dustpot/electronic-test-bench/software/readme.md

Run checkA_main.py to start the system.

Modules used by checkA_main.py:
- adc.py
- digipot_dual.py
- inputs.py
- lcd.py
- freq_measure.py
