dustpot/electronic-test-bench/hardware/schematics/Ohmmeter.pdf

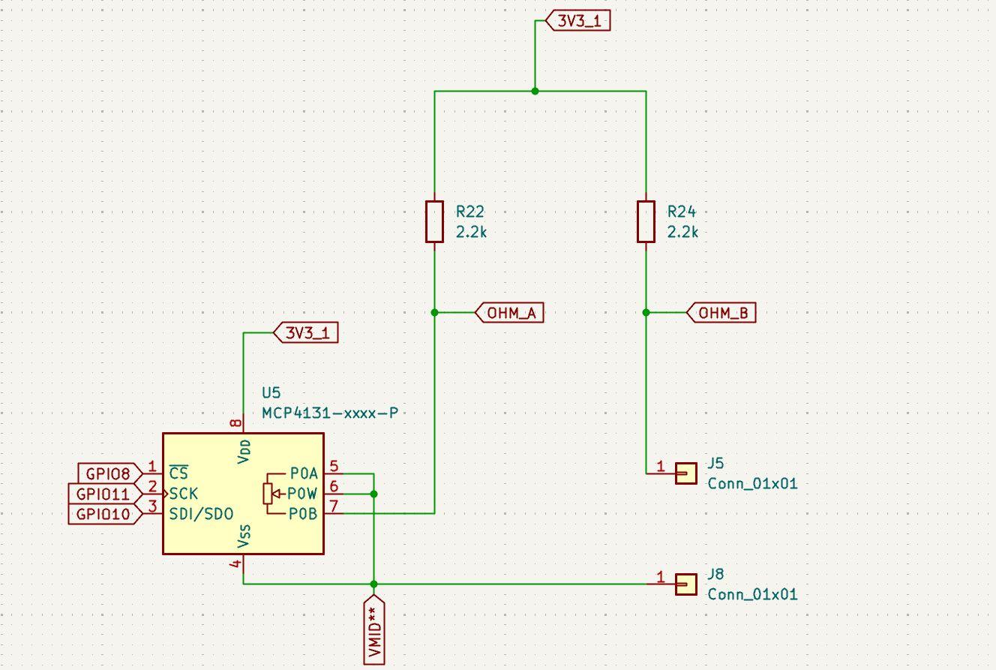
[picture p26: page 1]
