dustpot/electronic-test-bench/hardware/schematics/R2R_Ladder_ADC.pdf

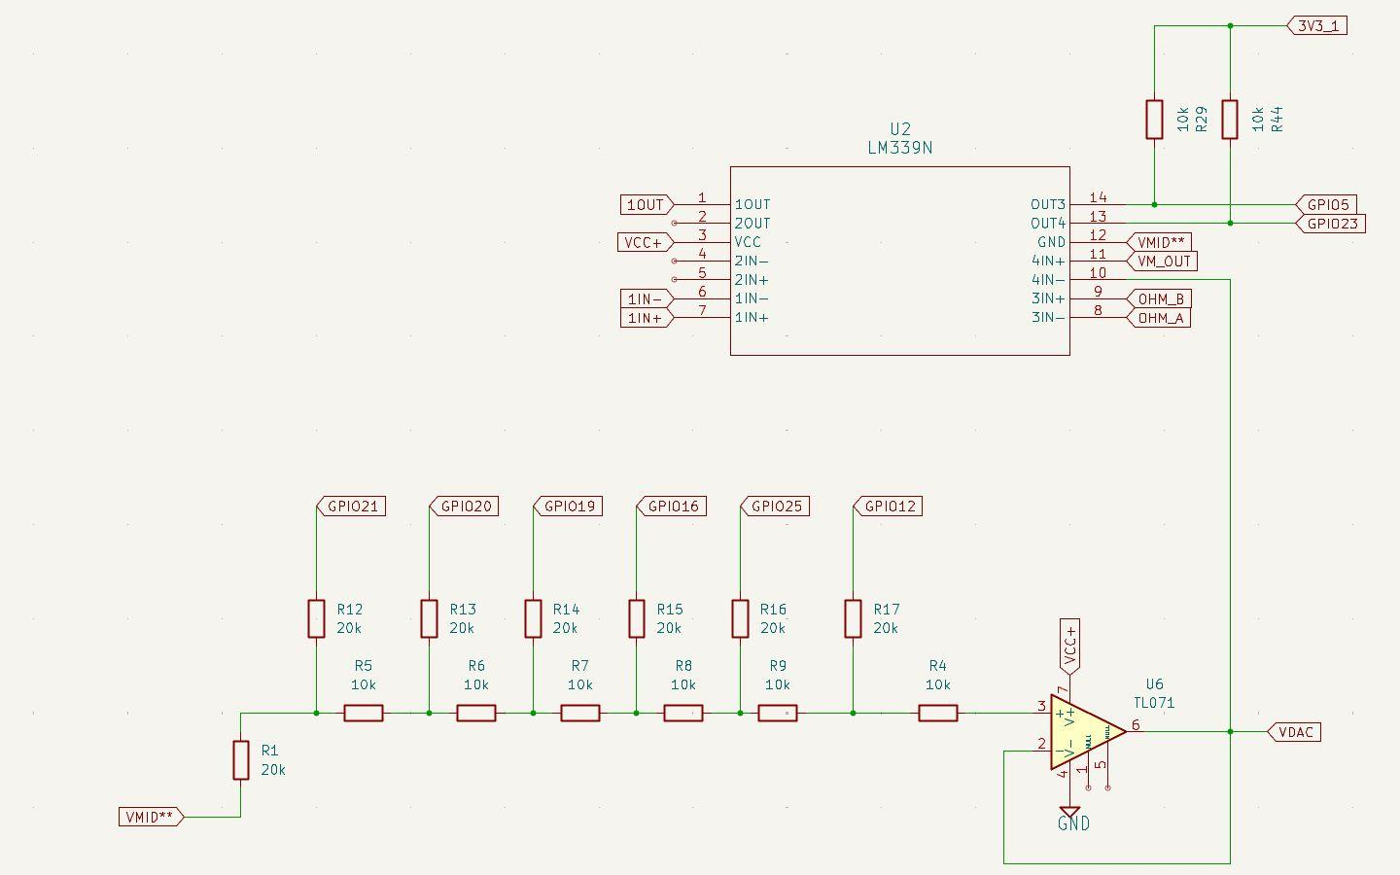
[picture p27: page 1]
