dustpot/electronic-test-bench/hardware/schematics/Virtual_Ground_Power_Supply.pdf

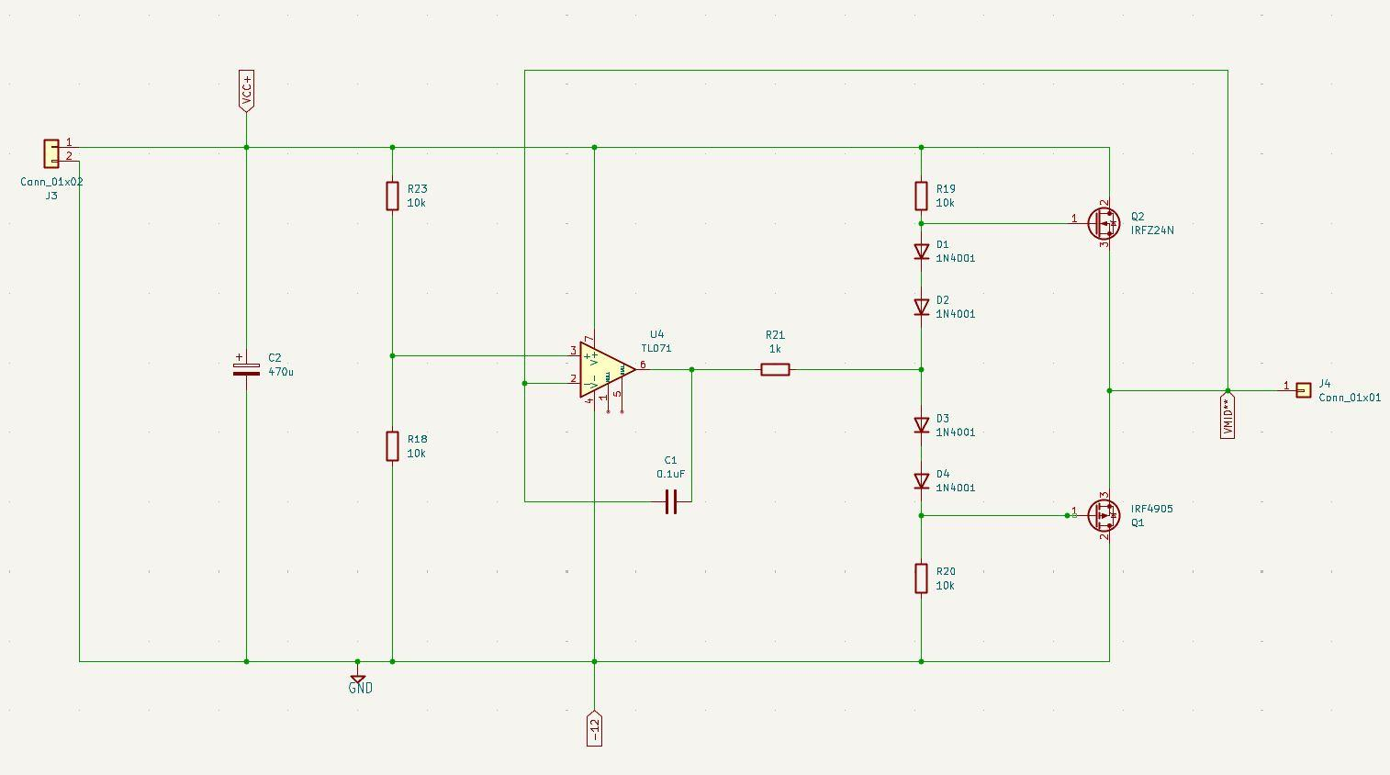
[picture p28: page 1]
