dustpot/electronic-test-bench/hardware/schematics/Voltmeter.pdf

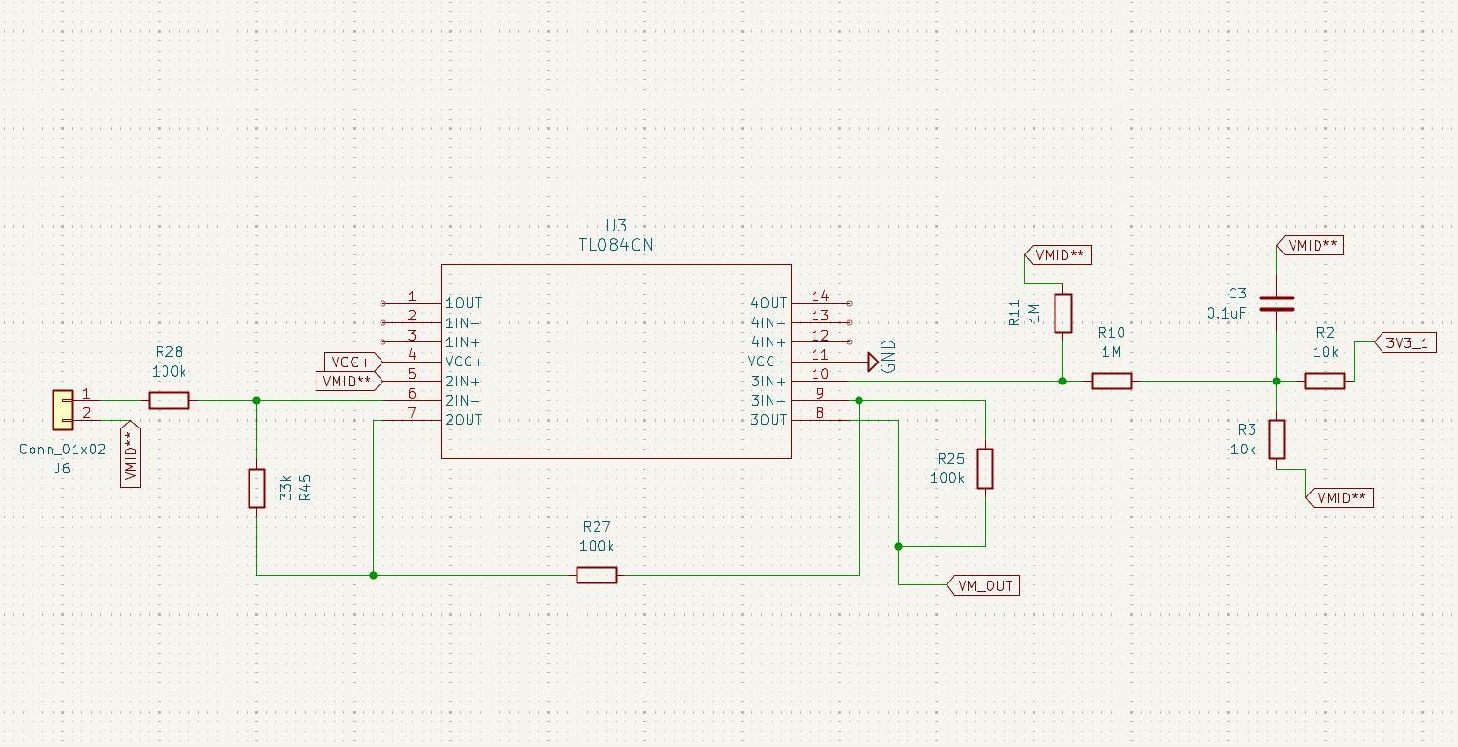
[picture p29: page 1]
