dustpot/electronic-test-bench/hardware/schematics/DC_Reference.pdf

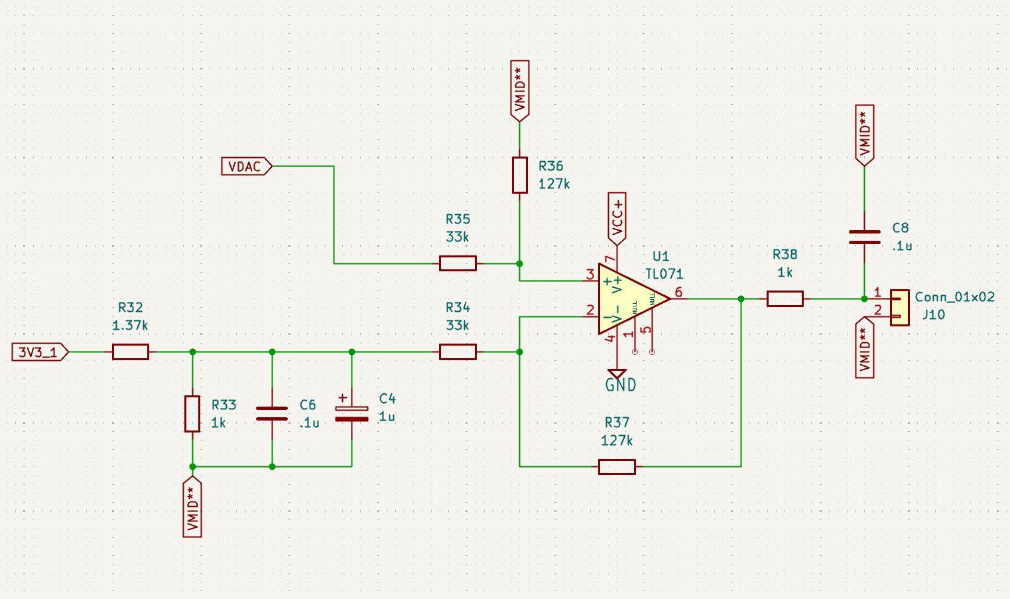
[picture p30: page 1]
