dustpot/electronic-test-bench/hardware/schematics/Function_Generator.pdf

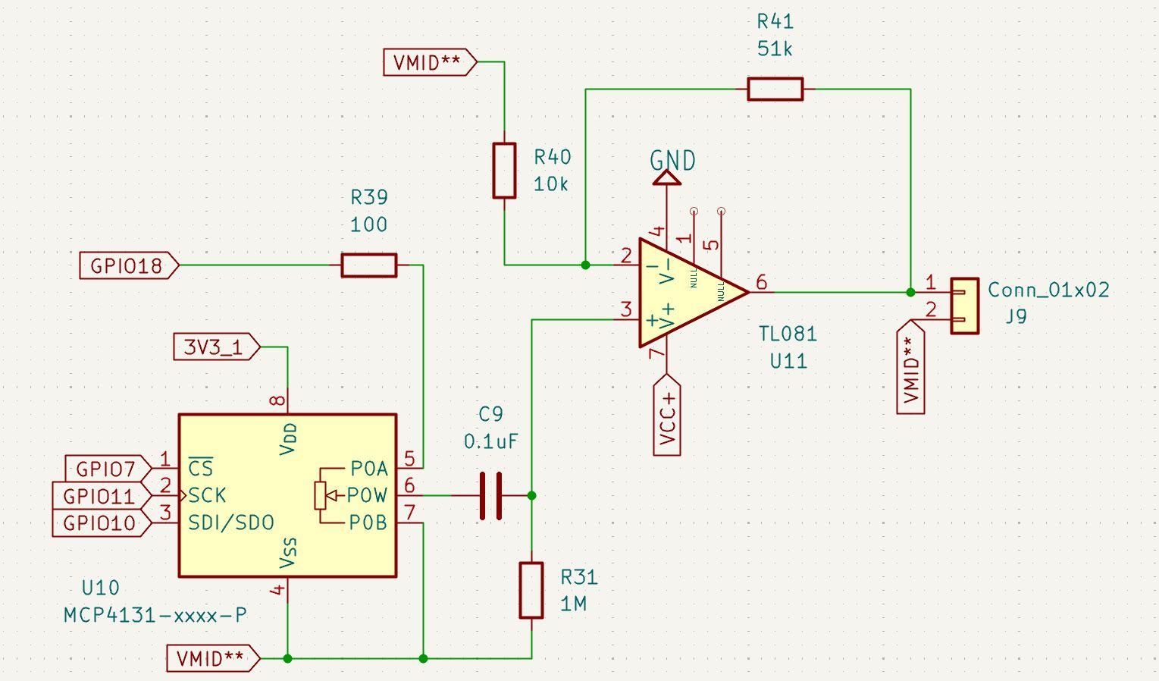
[picture p31: page 1]
