dustpot/electronic-test-bench/hardware/schematics/Sine_Wave_Generator.pdf

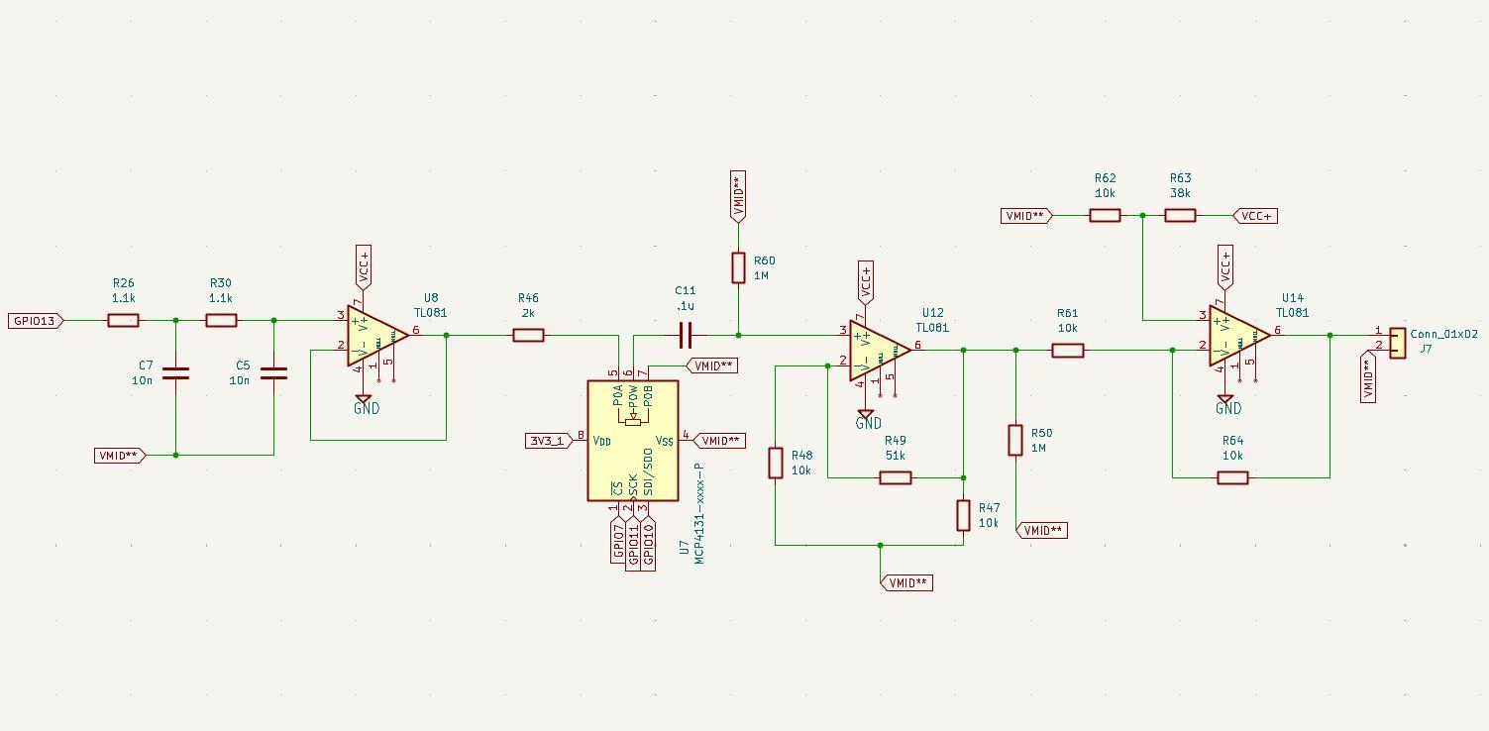
[picture p32: page 1]
