dustpot/electronic-test-bench/hardware/schematics/Voltage_Reference_Buffer.pdf

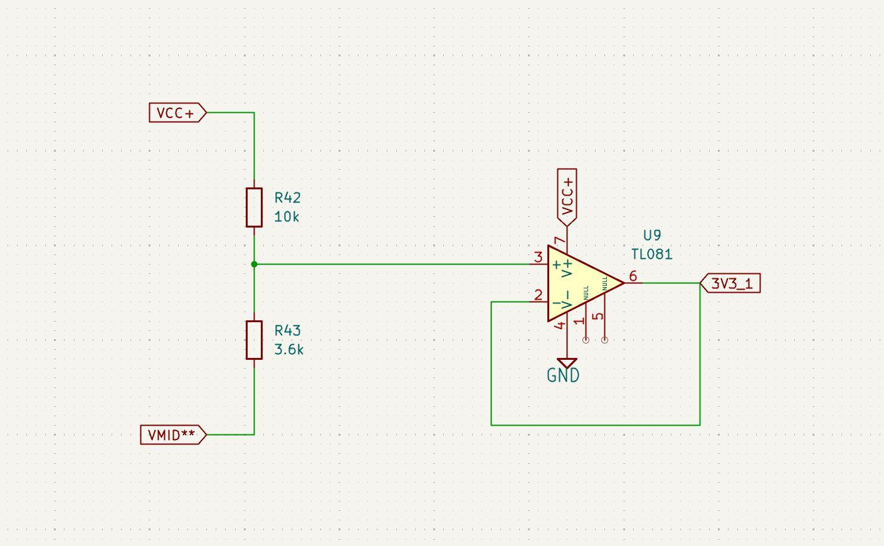
[picture p33: page 1]
