dustpot/electronic-test-bench/docs/User Manual.pdf

Last Updated: 13 Jan 2026
Jakob Braski, Avery Dedjoe, Justin Park, Sam Baker, Allan

## Project Overview:

eLC Project description: https://uga.view.usg.edu/d2l/le/content/3771272/viewContent/60154082/View

## Hardware:

See updated hardware list (https://docs.google.com/document/d/1_rCGydusvpgEHf9DDbCFCnacnoyjlU1H/edit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)

## Setup:

Setup for the SD card; hostname: "RP4-Group4", username: "rp4-group4", password: "group4" Remote connection via MobaXterm instructions: In MobaXterm, in the upper left corner go to Session > SSH. For remote host, enter the IP address of the RP4. For username, enter “rp4-group4”. Leave Port as “22”. Click “OK” and you should connect.

## Issues:

- Couldn’t find exact diode for circuit schematic
- Unable to remotely connect to RP4 through WiFi (same network, correct host and user names; problem is something else)
- Didn’t know how to create a new folder and move files to different locations on GitHub

## Issues Resolved:

- Quick Google search helped with new folders and moving files
- Able to remotely connect to RP4 through WiFi on hotspot network (fixed by using MobaXterm instead of powershell on Windows)
