dustpot/electronic-test-bench/hardware/schematics/Frequency_Measurement.pdf

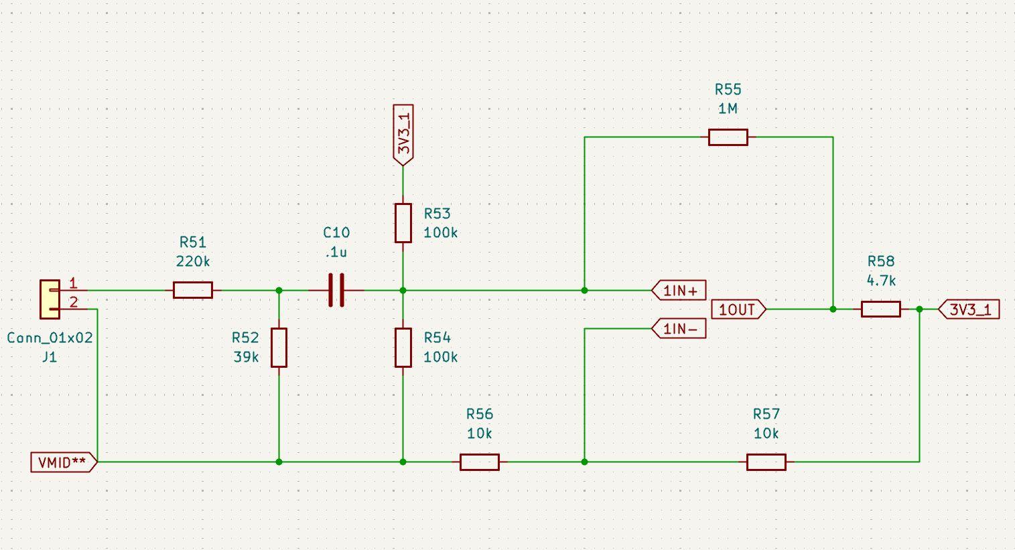
[picture p34: page 1]
