dustpot/electronic-test-bench/hardware/kicad/Group4_CheckpointA_KiCad_4-20-26.kicad_pcb

## KiCad design hardware/kicad/Group4_CheckpointA_KiCad_4-20-26.kicad_pcb (2026-10-09)

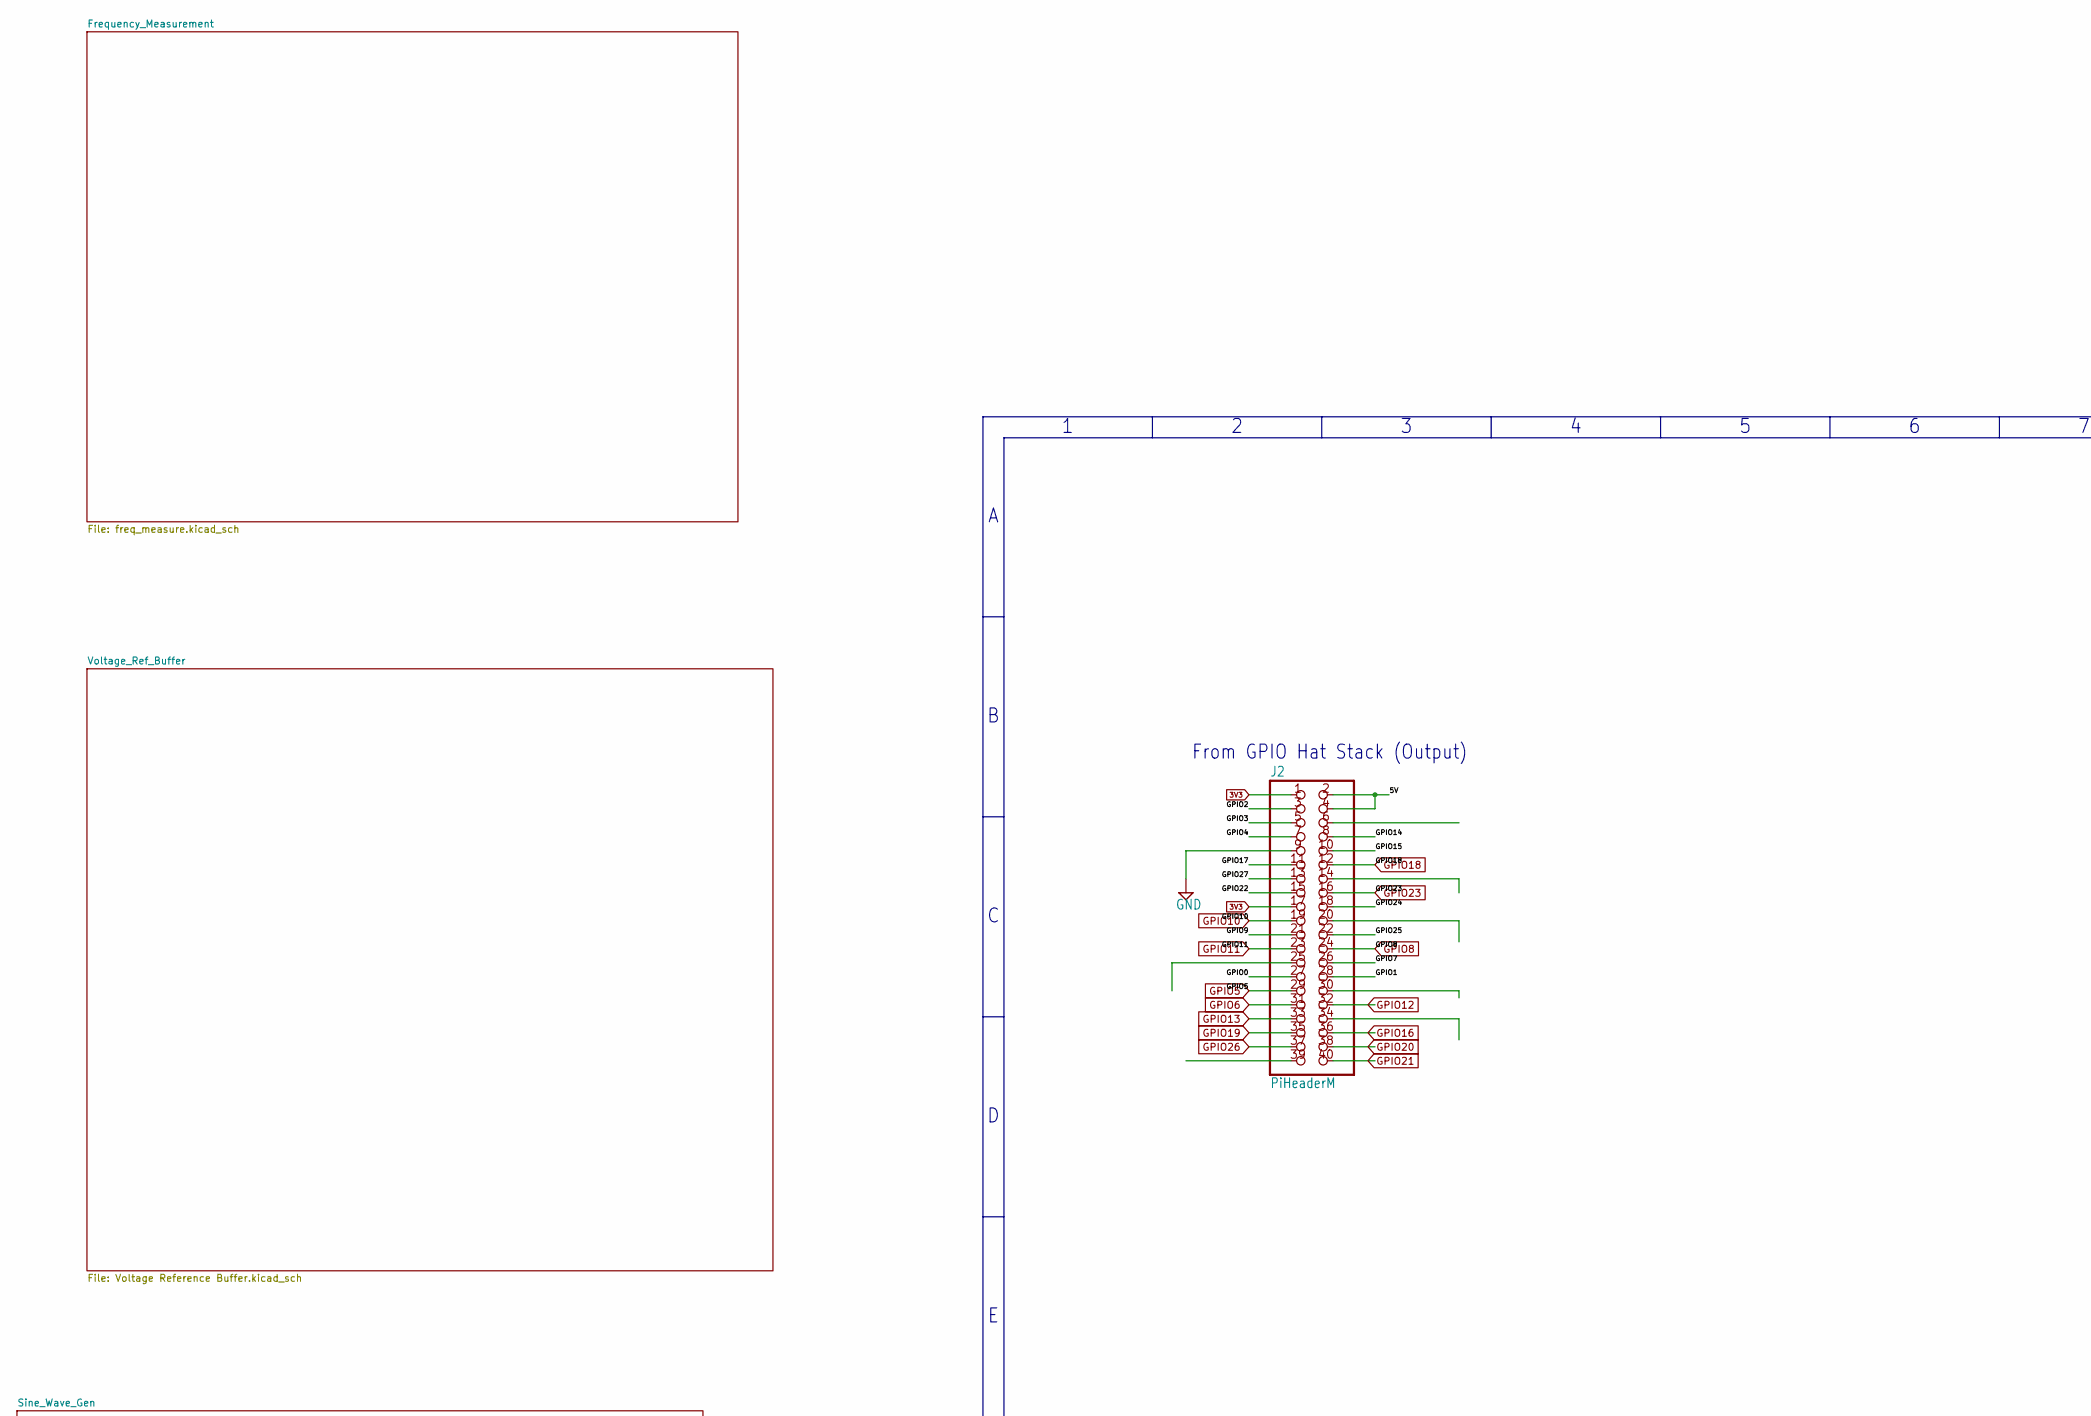
[picture p35: schematic Group4_CheckpointA_KiCad_4-20-26.kicad_sch, part in row 1, column 1]

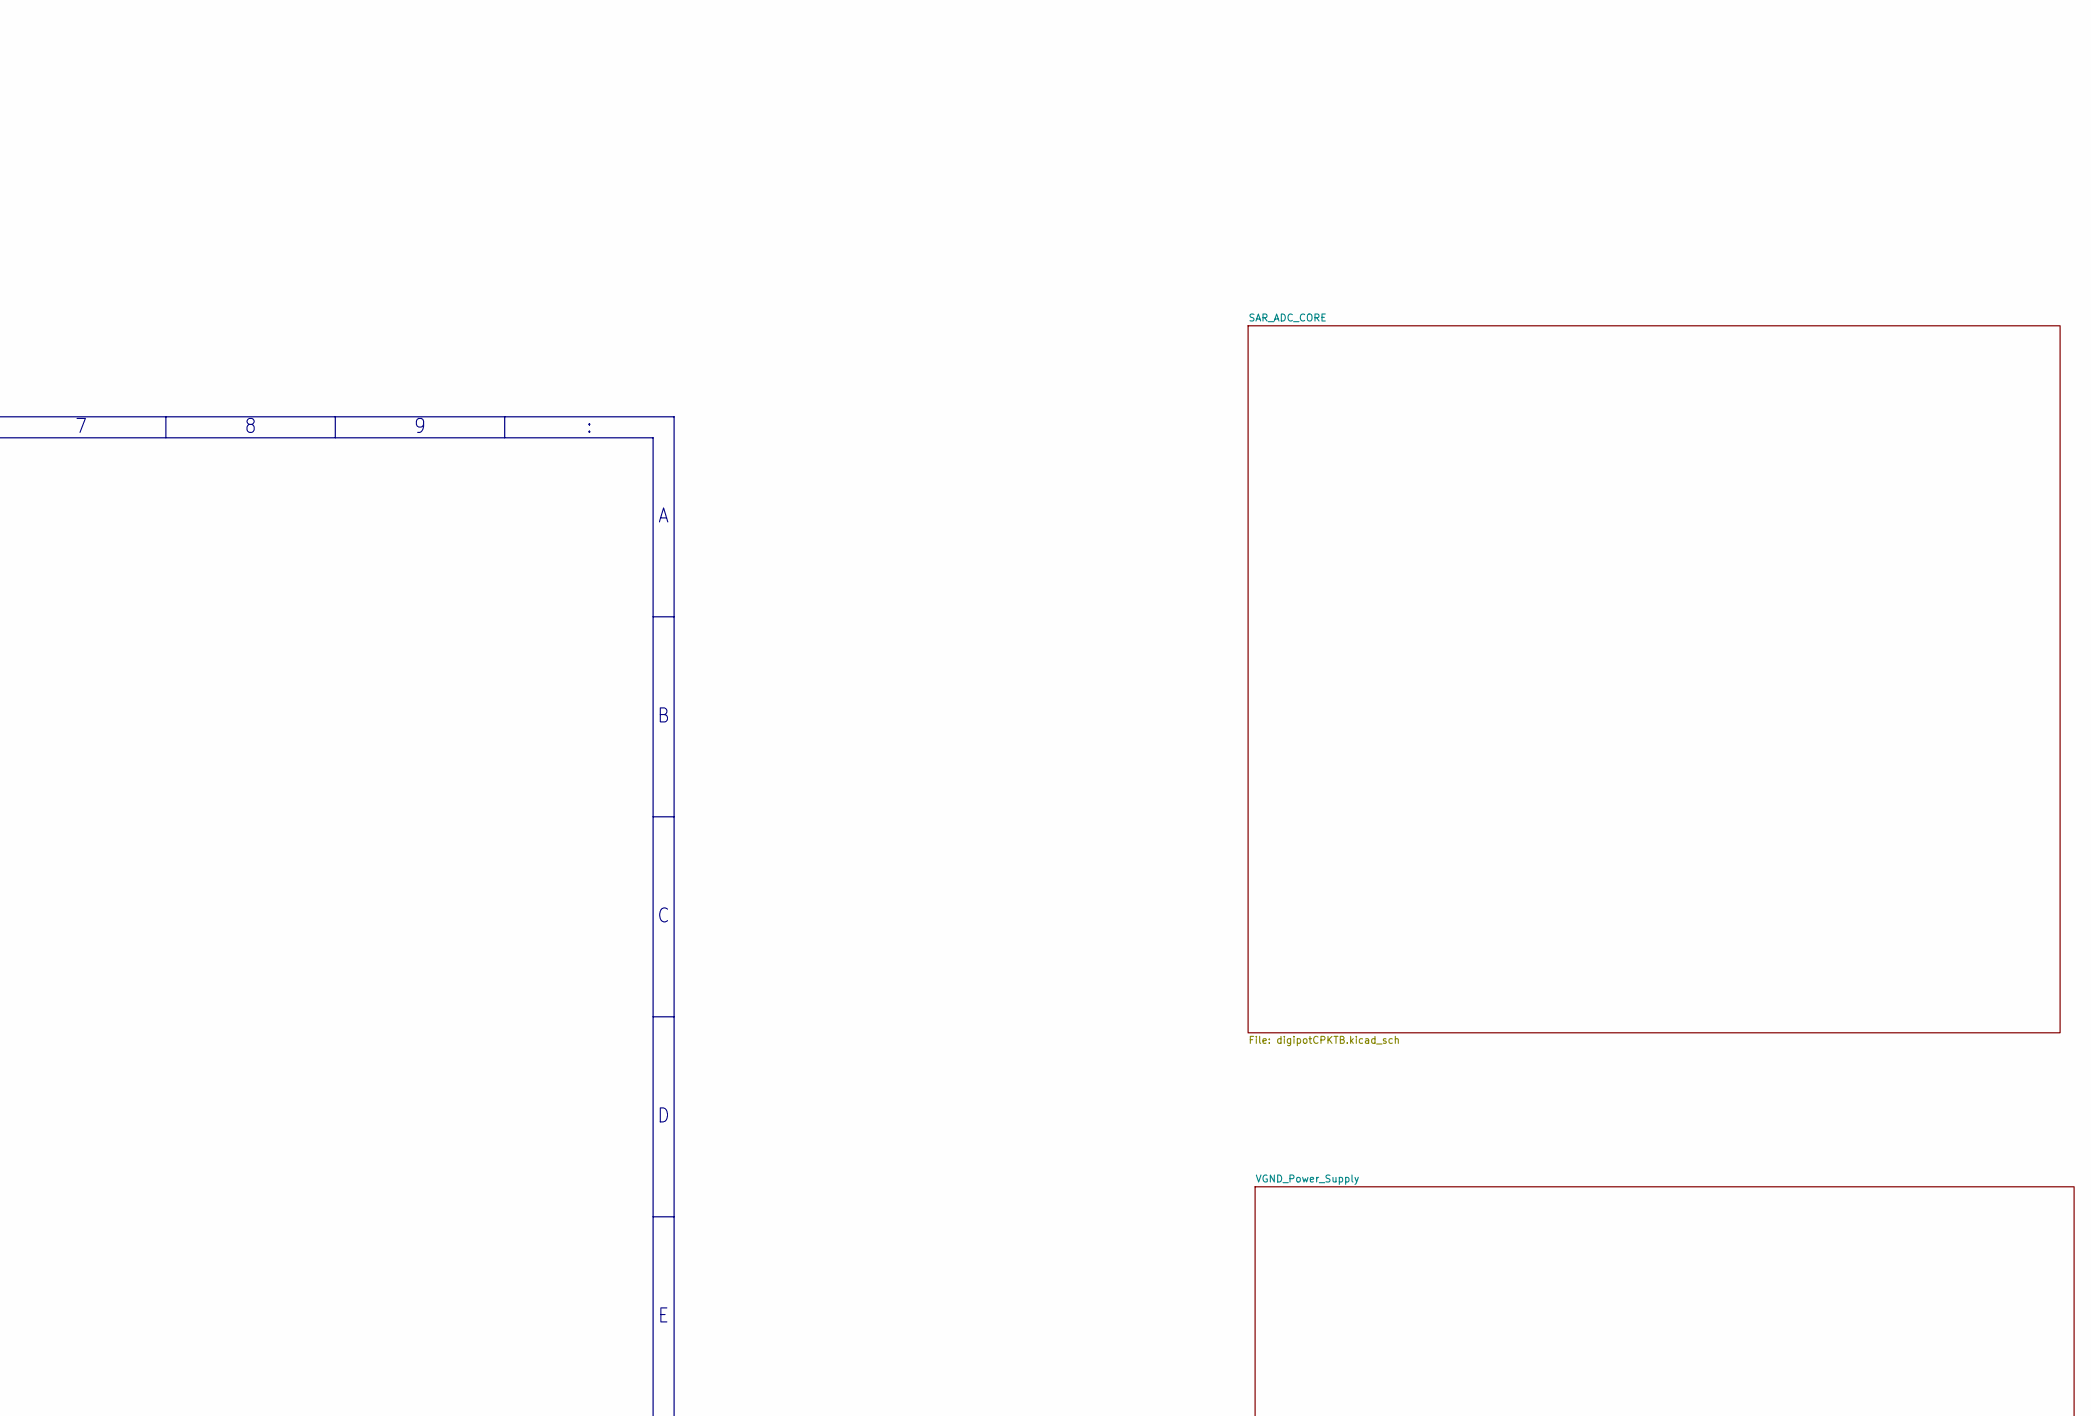
[picture p36: schematic Group4_CheckpointA_KiCad_4-20-26.kicad_sch, part in row 1, column 2]

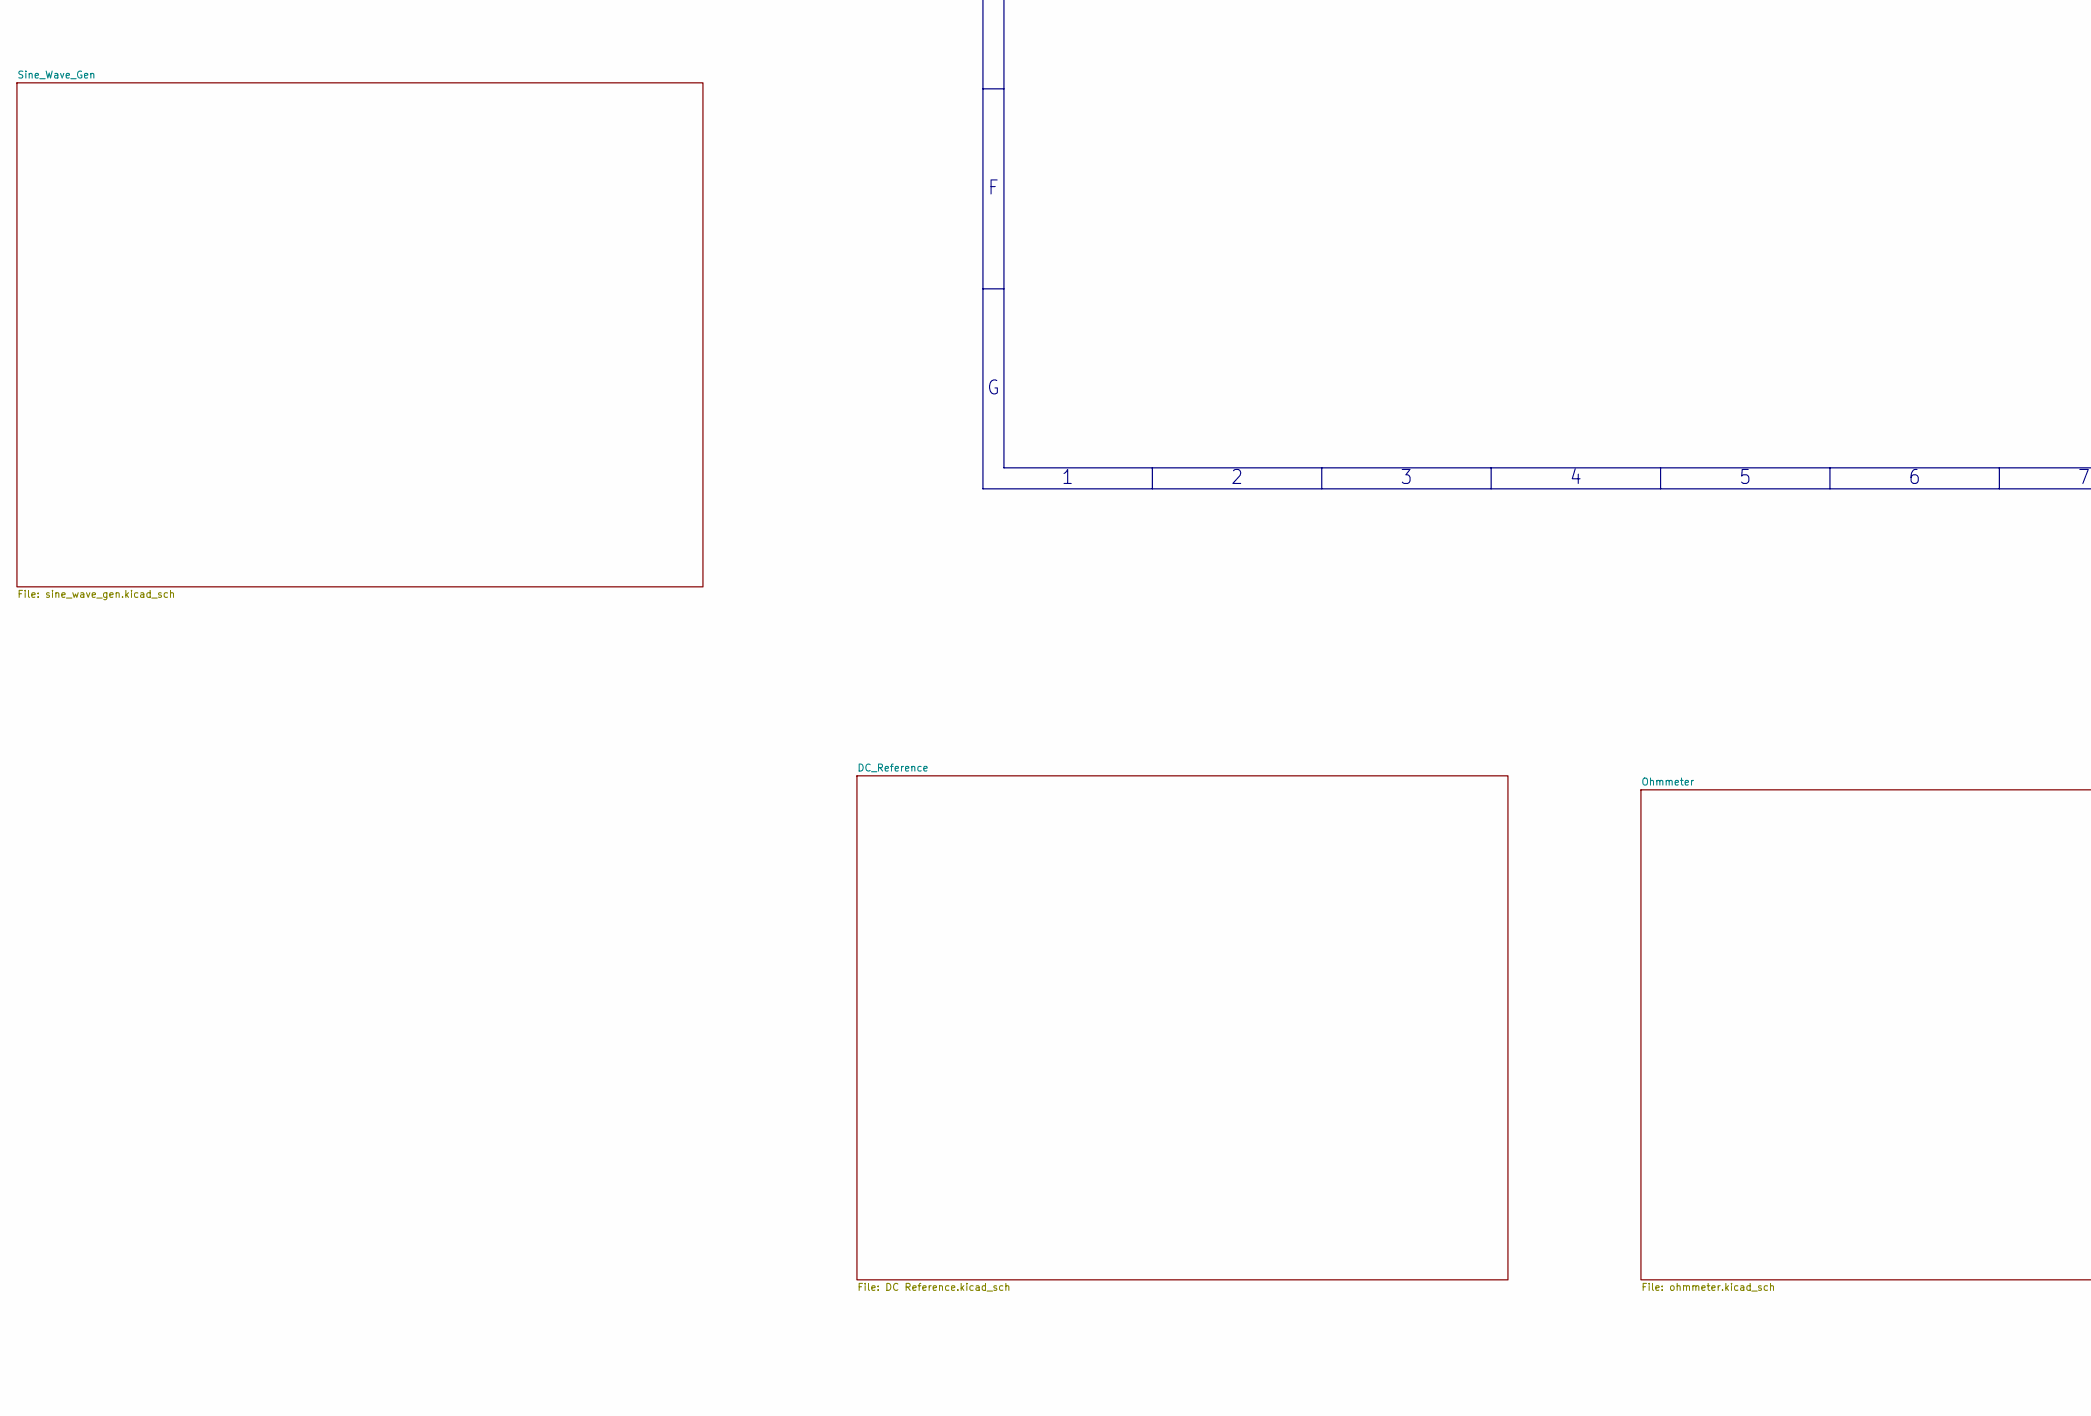
[picture p37: schematic Group4_CheckpointA_KiCad_4-20-26.kicad_sch, part in row 2, column 1]

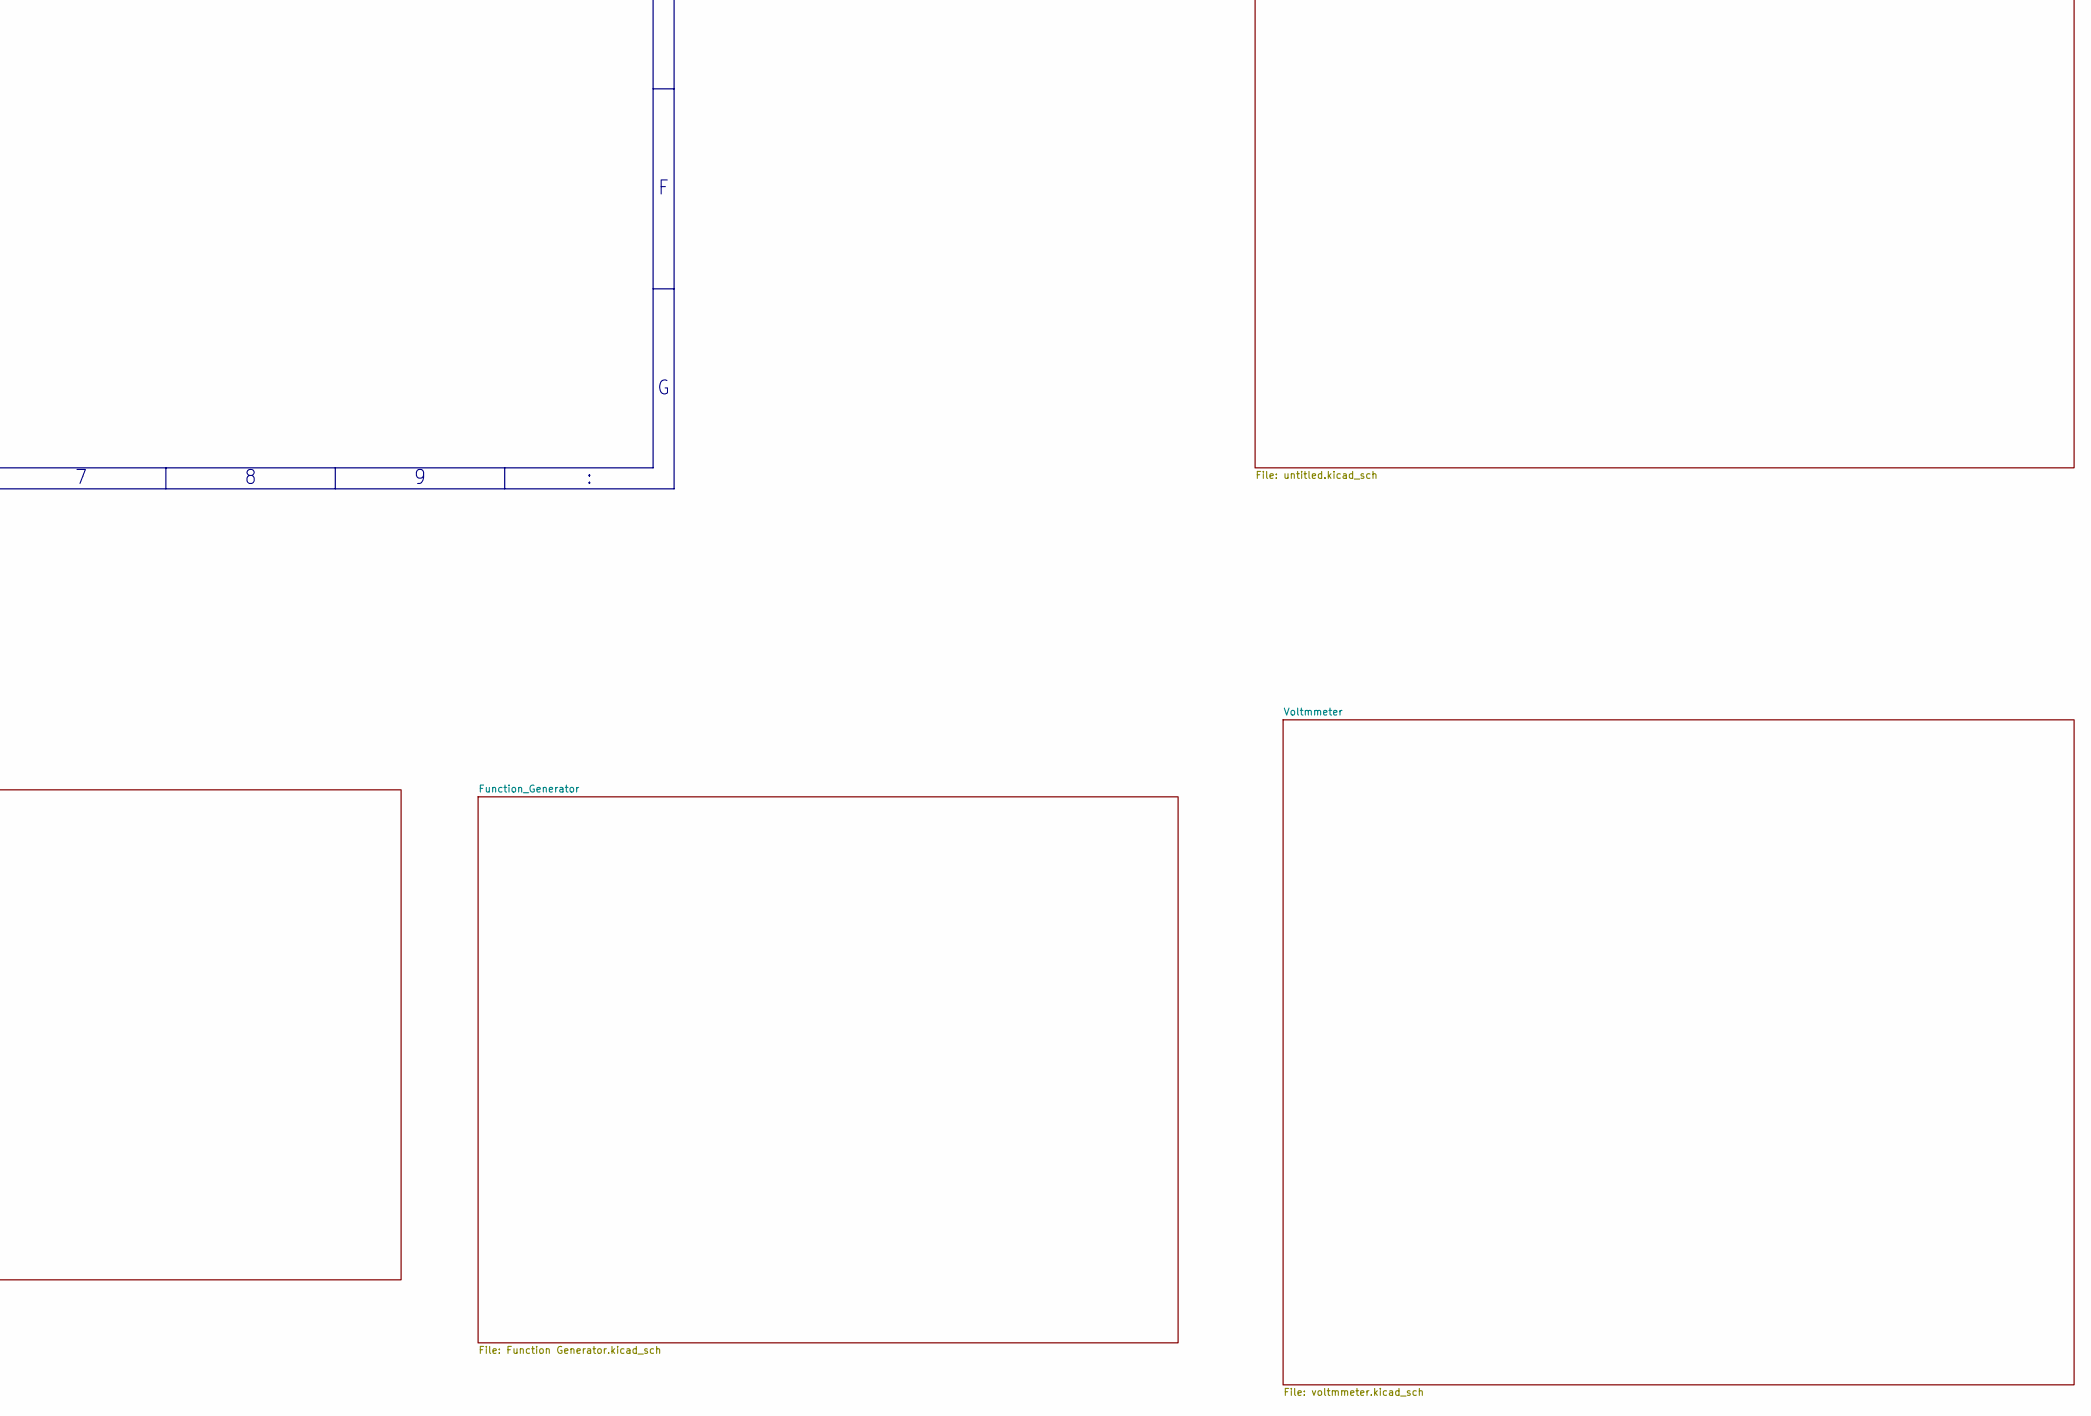
[picture p38: schematic Group4_CheckpointA_KiCad_4-20-26.kicad_sch, part in row 2, column 2]

Parts:
J2: PiHeaderM; PinHeader_2x20_P2.54mm_Vertical

Connections:
3V3: J2.1, J2.17
-12: J2.9; also elsewhere on the board
/5V: J2.2, J2.4
/GPIO0: J2.27
/GPIO1: J2.28
/GPIO2: J2.3
/GPIO3: J2.5
/GPIO4: J2.7
/GPIO7: J2.26
/GPIO9: J2.21
/GPIO14: J2.8
/GPIO15: J2.10
/GPIO17: J2.11
/GPIO22: J2.15
/GPIO24: J2.18
/GPIO25: J2.22
/GPIO27: J2.13
GPIO5: J2.29; also elsewhere on the board
GPIO6: J2.31
GPIO8: J2.24; also elsewhere on the board
GPIO10: J2.19; also elsewhere on the board
GPIO11: J2.23; also elsewhere on the board
GPIO12: J2.32; also elsewhere on the board
GPIO13: J2.33; also elsewhere on the board
GPIO16: J2.36; also elsewhere on the board
GPIO18: J2.12; also elsewhere on the board
GPIO19: J2.35; also elsewhere on the board
GPIO20: J2.38; also elsewhere on the board
GPIO21: J2.40; also elsewhere on the board
GPIO23: J2.16; also elsewhere on the board
GPIO26: J2.37

Notes on the sheet:
From GPIO Hat Stack (Output)

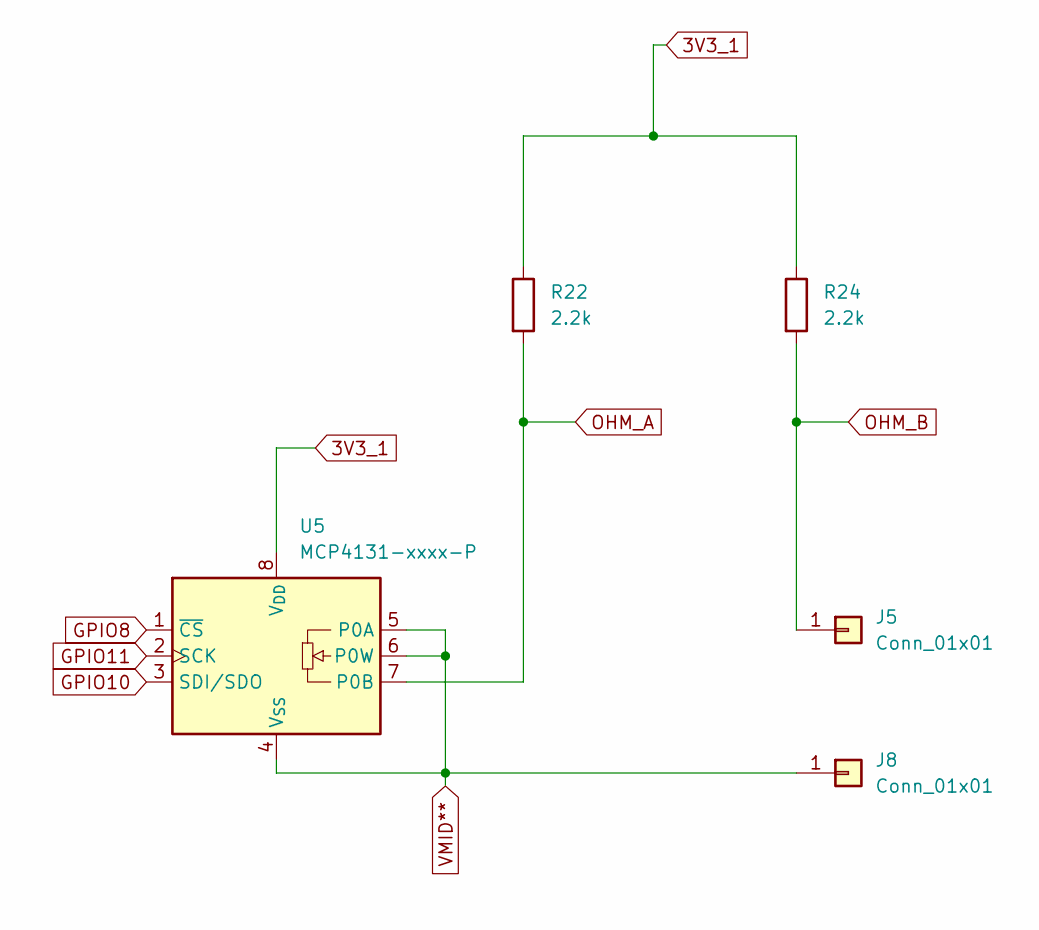
[picture p39: schematic ohmmeter.kicad_sch]

Parts:
J5, J8: Conn_01x01; PinHeader_1x01_P2.54mm_Vertical
R22, R24: 2.2k; R_Axial_DIN0207_L6.3mm_D2.5mm_P2.54mm_Vertical
U5: MCP4131-xxxx-P; DIP-8_W7.62mm

Connections:
3V3_1: R22.1, R24.1, U5.8 (V_{DD}); also elsewhere on the board
GPIO8: U5.1 (~CS); also elsewhere on the board
GPIO10: U5.3 (SDI/SDO); also elsewhere on the board
GPIO11: U5.2 (SCK); also elsewhere on the board
OHM_A: R22.2, U5.7 (P0B); also elsewhere on the board
OHM_B: J5.1, R24.2; also elsewhere on the board
VMID**: J8.1, U5.4 (V_{SS}), U5.5 (P0A), U5.6 (P0W); also elsewhere on the board

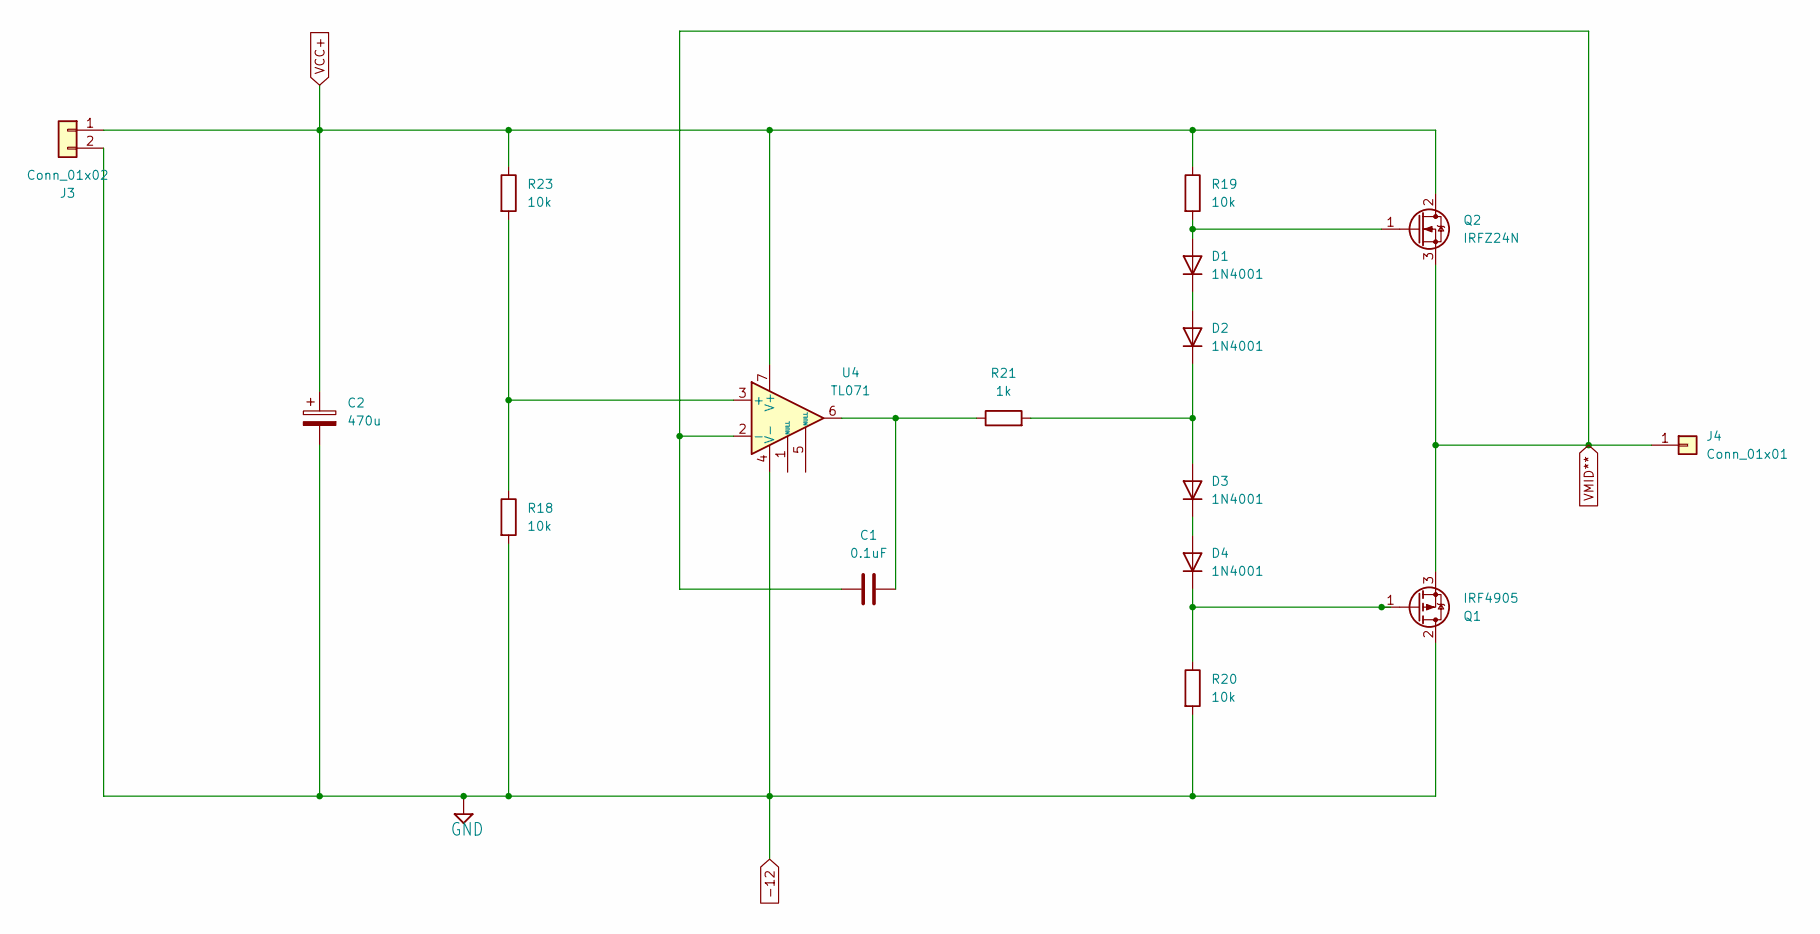
[picture p40: schematic untitled.kicad_sch]

Parts:
C1: 0.1uF; C_Disc_D5.0mm_W2.5mm_P2.50mm
C2: 470u; CP_Radial_D10.0mm_P5.00mm
D1, D2, D3, D4: 1N4001; D_DO-41_SOD81_P10.16mm_Horizontal
J3: Conn_01x02; PinHeader_1x02_P2.54mm_Vertical
J4: Conn_01x01; PinHeader_1x01_P2.54mm_Vertical
Q1: IRF4905; TO-220-3_Vertical
Q2: IRFZ24N; TO-220-3_Vertical
R18, R19, R20, R23: 10k; R_Axial_DIN0207_L6.3mm_D2.5mm_P2.54mm_Vertical
R21: 1k; R_Axial_DIN0207_L6.3mm_D2.5mm_P2.54mm_Vertical
U4: TL071; DIP-8_W7.62mm

Connections:
-12: C2.2, J3.2, Q1.2 (D), R18.2, R20.2, U4.4 (V-); also elsewhere on the board
unnamed: C1.2, R21.1, U4.6
unnamed: D1.2 (A), Q2.1 (G), R19.2
unnamed: D1.1 (K), D2.2 (A)
unnamed: D2.1 (K), D3.2 (A), R21.2
unnamed: D3.1 (K), D4.2 (A)
unnamed: D4.1 (K), Q1.1 (G), R20.1
unnamed: R18.1, R23.2, U4.3 (+)
VCC+: C2.1, J3.1, Q2.2 (D), R19.1, R23.1, U4.7 (V+); also elsewhere on the board
VMID**: C1.1, J4.1, Q1.3 (S), Q2.3 (S), U4.2 (-); also elsewhere on the board

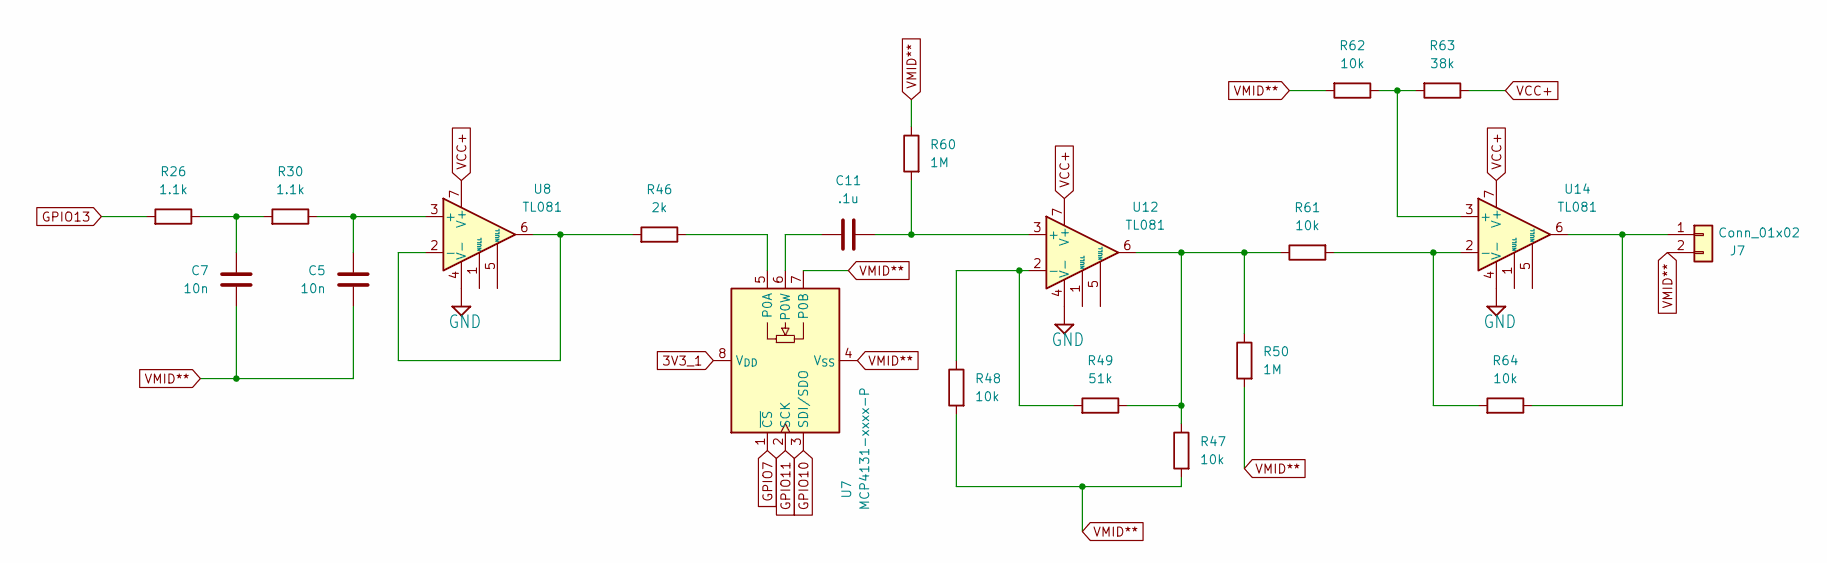
[picture p41: schematic sine_wave_gen.kicad_sch]

Parts:
C5, C7: 10n; C_Disc_D5.0mm_W2.5mm_P2.50mm
C11: .1u; C_Disc_D5.0mm_W2.5mm_P2.50mm
J7: Conn_01x02; PinHeader_1x02_P2.54mm_Vertical
R26, R30: 1.1k; R_Axial_DIN0207_L6.3mm_D2.5mm_P2.54mm_Vertical
R46: 2k; R_Axial_DIN0207_L6.3mm_D2.5mm_P2.54mm_Vertical
R47, R48, R61, R62, R64: 10k; R_Axial_DIN0207_L6.3mm_D2.5mm_P2.54mm_Vertical
R49: 51k; R_Axial_DIN0207_L6.3mm_D2.5mm_P2.54mm_Vertical
R50, R60: 1M; R_Axial_DIN0207_L6.3mm_D2.5mm_P2.54mm_Vertical
R63: 38k; R_Axial_DIN0207_L6.3mm_D2.5mm_P2.54mm_Vertical
U7: MCP4131-xxxx-P; DIP-8_W7.62mm
U8, U12, U14: TL081; DIP-8_W7.62mm

Connections:
3V3_1: U7.8 (V_{DD}); also elsewhere on the board
-12: U8.4 (V-), U12.4 (V-), U14.4 (V-); also elsewhere on the board
GPIO7: U7.1 (~CS); also elsewhere on the board
GPIO10: U7.3 (SDI/SDO); also elsewhere on the board
GPIO11: U7.2 (SCK); also elsewhere on the board
GPIO13: R26.2; also elsewhere on the board
unnamed: C7.2, R26.1, R30.2
unnamed: J7.1, R64.1, U14.6
unnamed: R47.1, R49.1, R50.1, R61.1, U12.6
unnamed: R46.1, U7.5 (P0A)
unnamed: C11.2, U7.6 (P0W)
unnamed: C5.2, R30.1, U8.3 (+)
unnamed: R46.2, U8.2 (-), U8.6
unnamed: C11.1, R60.2, U12.3 (+)
unnamed: R48.1, R49.2, U12.2 (-)
unnamed: R62.1, R63.2, U14.3 (+)
unnamed: R61.2, R64.2, U14.2 (-)
VCC+: R63.1, U8.7 (V+), U12.7 (V+), U14.7 (V+); also elsewhere on the board
VMID**: C5.1, C7.1, J7.2, R47.2, R48.2, R50.2, R60.1, R62.2, U7.4 (V_{SS}), U7.7 (P0B); also elsewhere on the board

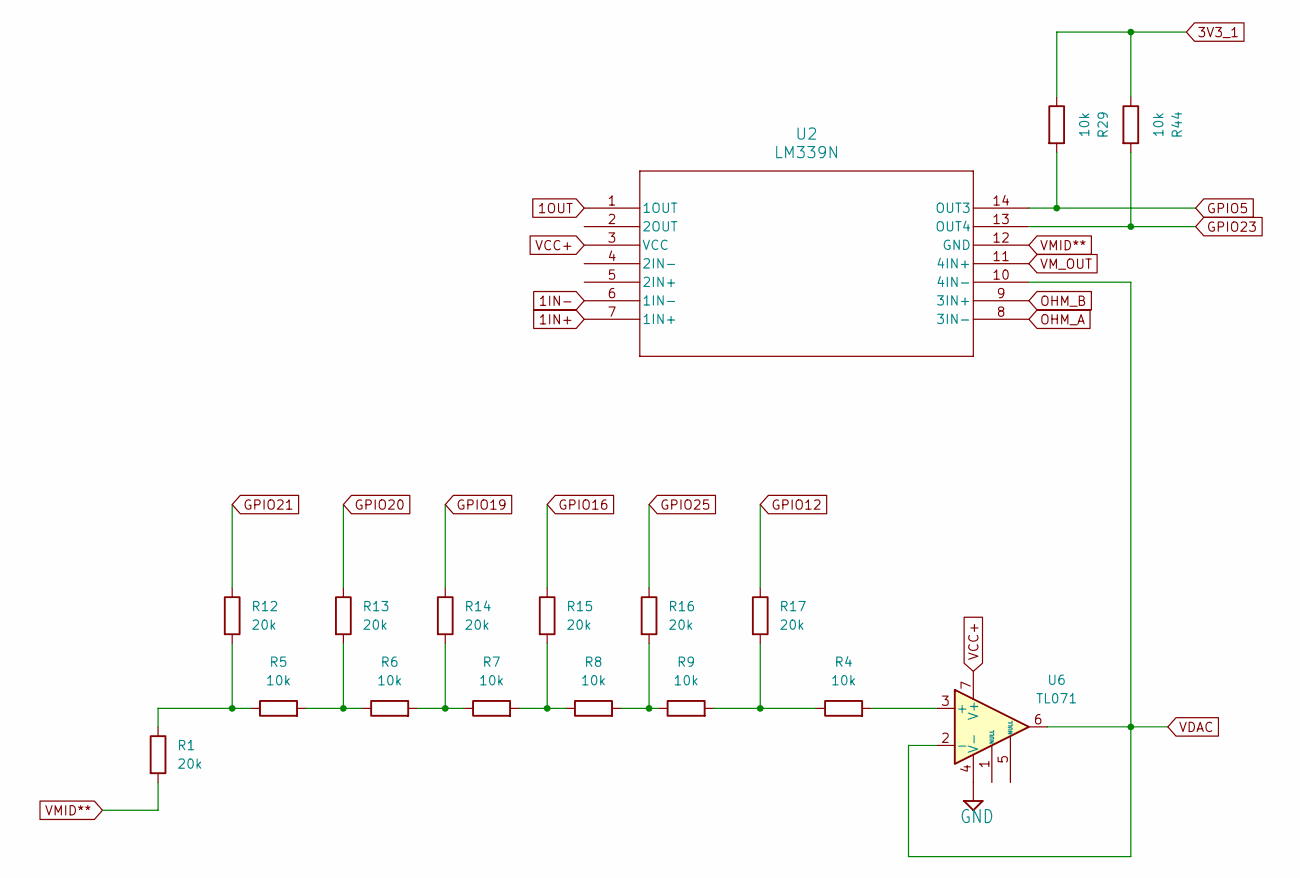
[picture p42: schematic digipotCPKTB.kicad_sch]

Parts:
R1, R12, R13, R14, R15, R16, R17: 20k; R_Axial_DIN0207_L6.3mm_D2.5mm_P2.54mm_Vertical
R4, R5, R6, R7, R8, R9, R29, R44: 10k; R_Axial_DIN0207_L6.3mm_D2.5mm_P2.54mm_Vertical
U2: LM339N; DIP-14_W7.62mm
U6: TL071; DIP-8_W7.62mm

Connections:
1IN+: U2.7 (1IN+); also elsewhere on the board
1IN-: U2.6 (1IN-); also elsewhere on the board
1OUT: U2.1 (1OUT); also elsewhere on the board
3V3_1: R29.1, R44.1; also elsewhere on the board
-12: U6.4 (V-); also elsewhere on the board
GPIO5: R29.2, U2.14 (OUT3); also elsewhere on the board
GPIO12: R17.1; also elsewhere on the board
GPIO16: R15.1; also elsewhere on the board
GPIO19: R14.1; also elsewhere on the board
GPIO20: R13.1; also elsewhere on the board
GPIO21: R12.1; also elsewhere on the board
GPIO23: R44.2, U2.13 (OUT4); also elsewhere on the board
GPIO25: R16.1
unnamed: R1.1, R5.1, R12.2
unnamed: R5.2, R6.1, R13.2
unnamed: R6.2, R7.1, R14.2
unnamed: R7.2, R8.1, R15.2
unnamed: R8.2, R9.1, R16.2
unnamed: R4.1, R9.2, R17.2
unnamed: R4.2, U6.3 (+)
OHM_A: U2.8 (3IN-); also elsewhere on the board
OHM_B: U2.9 (3IN+); also elsewhere on the board
VCC+: U2.3 (VCC), U6.7 (V+); also elsewhere on the board
VDAC: U2.10 (4IN-), U6.2 (-), U6.6; also elsewhere on the board
VMID**: R1.2, U2.12 (GND); also elsewhere on the board
VM_OUT: U2.11 (4IN+); also elsewhere on the board

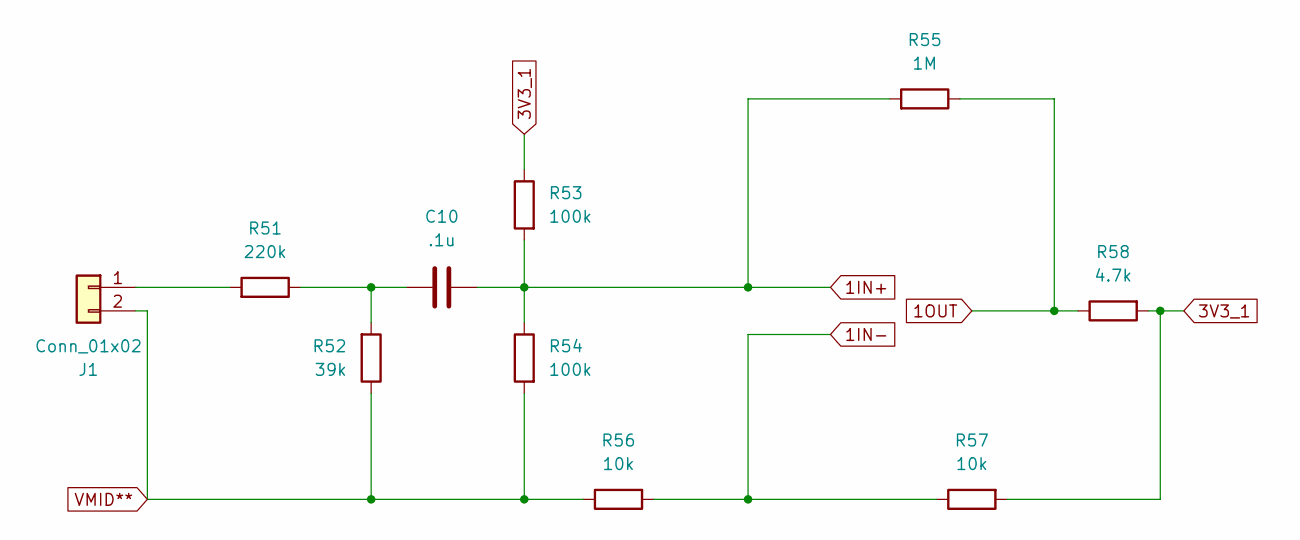
[picture p43: schematic freq_measure.kicad_sch]

Parts:
C10: .1u; C_Disc_D5.0mm_W2.5mm_P2.50mm
J1: Conn_01x02; PinHeader_1x02_P2.54mm_Vertical
R51: 220k; R_Axial_DIN0207_L6.3mm_D2.5mm_P2.54mm_Vertical
R52: 39k; R_Axial_DIN0207_L6.3mm_D2.5mm_P2.54mm_Vertical
R53, R54: 100k; R_Axial_DIN0207_L6.3mm_D2.5mm_P2.54mm_Vertical
R55: 1M; R_Axial_DIN0207_L6.3mm_D2.5mm_P2.54mm_Vertical
R56, R57: 10k; R_Axial_DIN0207_L6.3mm_D2.5mm_P2.54mm_Vertical
R58: 4.7k; R_Axial_DIN0207_L6.3mm_D2.5mm_P2.54mm_Vertical

Connections:
1IN+: C10.1, R53.2, R54.1, R55.2; also elsewhere on the board
1IN-: R56.2, R57.1; also elsewhere on the board
1OUT: R55.1, R58.1; also elsewhere on the board
3V3_1: R53.1, R57.2, R58.2; also elsewhere on the board
unnamed: C10.2, R51.1, R52.2
unnamed: J1.1, R51.2
VMID**: J1.2, R52.1, R54.2, R56.1; also elsewhere on the board

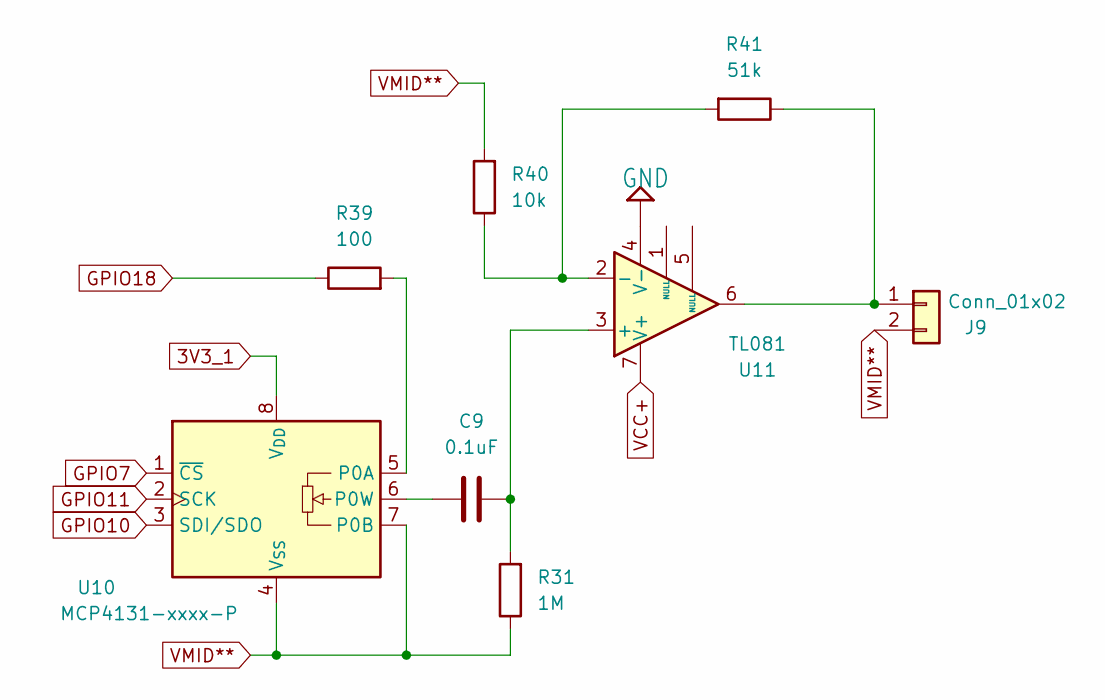
[picture p44: schematic Function Generator.kicad_sch]

Parts:
C9: 0.1uF; C_Disc_D5.0mm_W2.5mm_P2.50mm
J9: Conn_01x02; PinHeader_1x02_P2.54mm_Vertical
R31: 1M; R_Axial_DIN0207_L6.3mm_D2.5mm_P2.54mm_Vertical
R39: 100; R_Axial_DIN0207_L6.3mm_D2.5mm_P2.54mm_Vertical
R40: 10k; R_Axial_DIN0207_L6.3mm_D2.5mm_P2.54mm_Vertical
R41: 51k; R_Axial_DIN0207_L6.3mm_D2.5mm_P2.54mm_Vertical
U10: MCP4131-xxxx-P; DIP-8_W7.62mm
U11: TL081; DIP-8_W7.62mm

Connections:
3V3_1: U10.8 (V_{DD}); also elsewhere on the board
-12: U11.4 (V-); also elsewhere on the board
GPIO7: U10.1 (~CS); also elsewhere on the board
GPIO10: U10.3 (SDI/SDO); also elsewhere on the board
GPIO11: U10.2 (SCK); also elsewhere on the board
GPIO18: R39.1; also elsewhere on the board
unnamed: J9.1, R41.1, U11.6
unnamed: R39.2, U10.5 (P0A)
unnamed: C9.1, U10.6 (P0W)
unnamed: C9.2, R31.2, U11.3 (+)
unnamed: R40.1, R41.2, U11.2 (-)
VCC+: U11.7 (V+); also elsewhere on the board
VMID**: J9.2, R31.1, R40.2, U10.4 (V_{SS}), U10.7 (P0B); also elsewhere on the board
