dustpot/electronic-test-bench/hardware/kicad/Group4_CheckpointA_KiCad_4-20-26.kicad_pcb

## KiCad design hardware/kicad/Group4_CheckpointA_KiCad_4-20-26.kicad_pcb (continued)

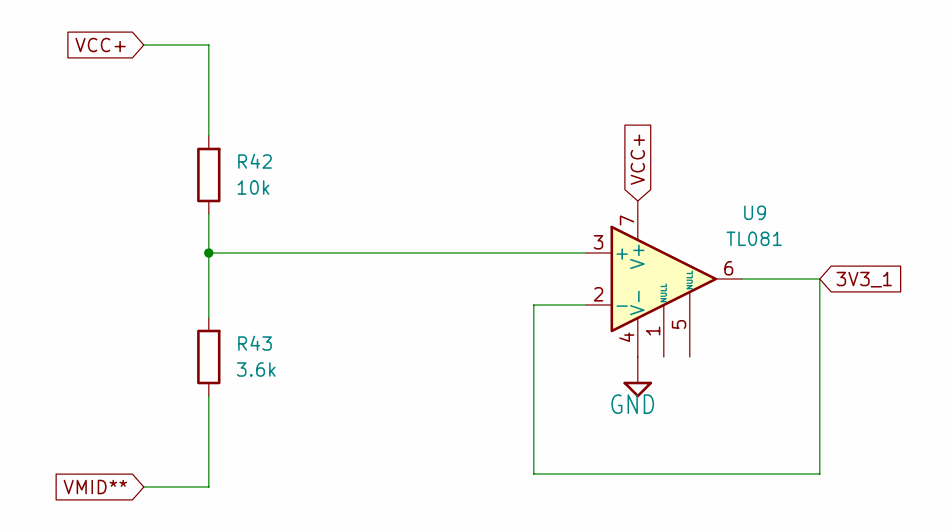
[picture p45: schematic Voltage Reference Buffer.kicad_sch]

Parts:
R42: 10k; R_Axial_DIN0207_L6.3mm_D2.5mm_P2.54mm_Vertical
R43: 3.6k; R_Axial_DIN0207_L6.3mm_D2.5mm_P2.54mm_Vertical
U9: TL081; DIP-8_W7.62mm

Connections:
3V3_1: U9.2 (-), U9.6; also elsewhere on the board
-12: U9.4 (V-); also elsewhere on the board
unnamed: R42.1, R43.2, U9.3 (+)
VCC+: R42.2, U9.7 (V+); also elsewhere on the board
VMID**: R43.1; also elsewhere on the board

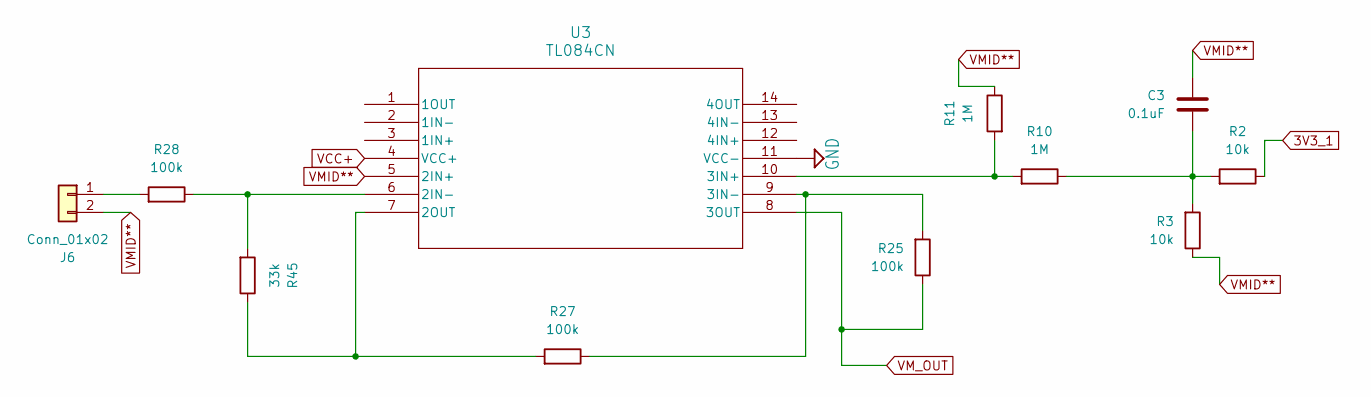
[picture p46: schematic voltmmeter.kicad_sch]

Parts:
C3: 0.1uF; C_Disc_D5.0mm_W2.5mm_P2.50mm
J6: Conn_01x02; PinHeader_1x02_P2.54mm_Vertical
R2, R3: 10k; R_Axial_DIN0207_L6.3mm_D2.5mm_P2.54mm_Vertical
R10, R11: 1M; R_Axial_DIN0207_L6.3mm_D2.5mm_P2.54mm_Vertical
R25, R27, R28: 100k; R_Axial_DIN0207_L6.3mm_D2.5mm_P2.54mm_Vertical
R45: 33k; R_Axial_DIN0207_L6.3mm_D2.5mm_P2.54mm_Vertical
U3: TL084CN; DIP-14_W7.62mm

Connections:
3V3_1: R2.1; also elsewhere on the board
-12: U3.11 (VCC-); also elsewhere on the board
unnamed: C3.1, R2.2, R3.2, R10.1
unnamed: J6.1, R28.2
unnamed: R28.1, R45.2, U3.6 (2IN-)
unnamed: R27.2, R45.1, U3.7 (2OUT)
unnamed: R10.2, R11.2, U3.10 (3IN+)
unnamed: R25.2, R27.1, U3.9 (3IN-)
VCC+: U3.4 (VCC+); also elsewhere on the board
VMID**: C3.2, J6.2, R3.1, R11.1, U3.5 (2IN+); also elsewhere on the board
VM_OUT: R25.1, U3.8 (3OUT); also elsewhere on the board

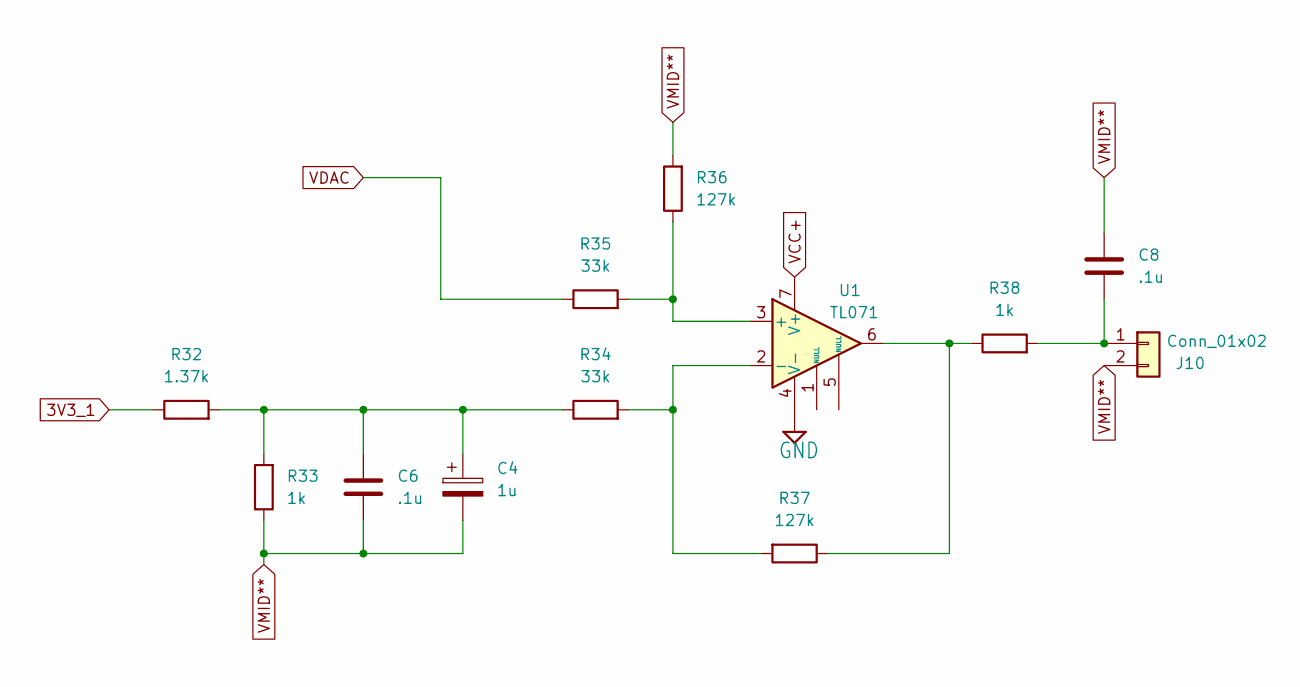
[picture p47: schematic DC Reference.kicad_sch]

Parts:
C4: 1u; CP_Radial_D10.0mm_P5.00mm
C6, C8: .1u; C_Disc_D5.0mm_W2.5mm_P5.00mm
J10: Conn_01x02; PinHeader_1x02_P2.54mm_Vertical
R32: 1.37k; R_Axial_DIN0207_L6.3mm_D2.5mm_P2.54mm_Vertical
R33, R38: 1k; R_Axial_DIN0207_L6.3mm_D2.5mm_P2.54mm_Vertical
R34, R35: 33k; R_Axial_DIN0207_L6.3mm_D2.5mm_P2.54mm_Vertical
R36, R37: 127k; R_Axial_DIN0207_L6.3mm_D2.5mm_P2.54mm_Vertical
U1: TL071; DIP-8_W7.62mm

Connections:
3V3_1: R32.1; also elsewhere on the board
-12: U1.4 (V-); also elsewhere on the board
unnamed: C4.1, C6.2, R32.2, R33.2, R34.1
unnamed: C8.1, J10.1, R38.2
unnamed: R37.1, R38.1, U1.6
unnamed: R35.2, R36.1, U1.3 (+)
unnamed: R34.2, R37.2, U1.2 (-)
VCC+: U1.7 (V+); also elsewhere on the board
VDAC: R35.1; also elsewhere on the board
VMID**: C4.2, C6.1, C8.2, J10.2, R33.1, R36.2; also elsewhere on the board

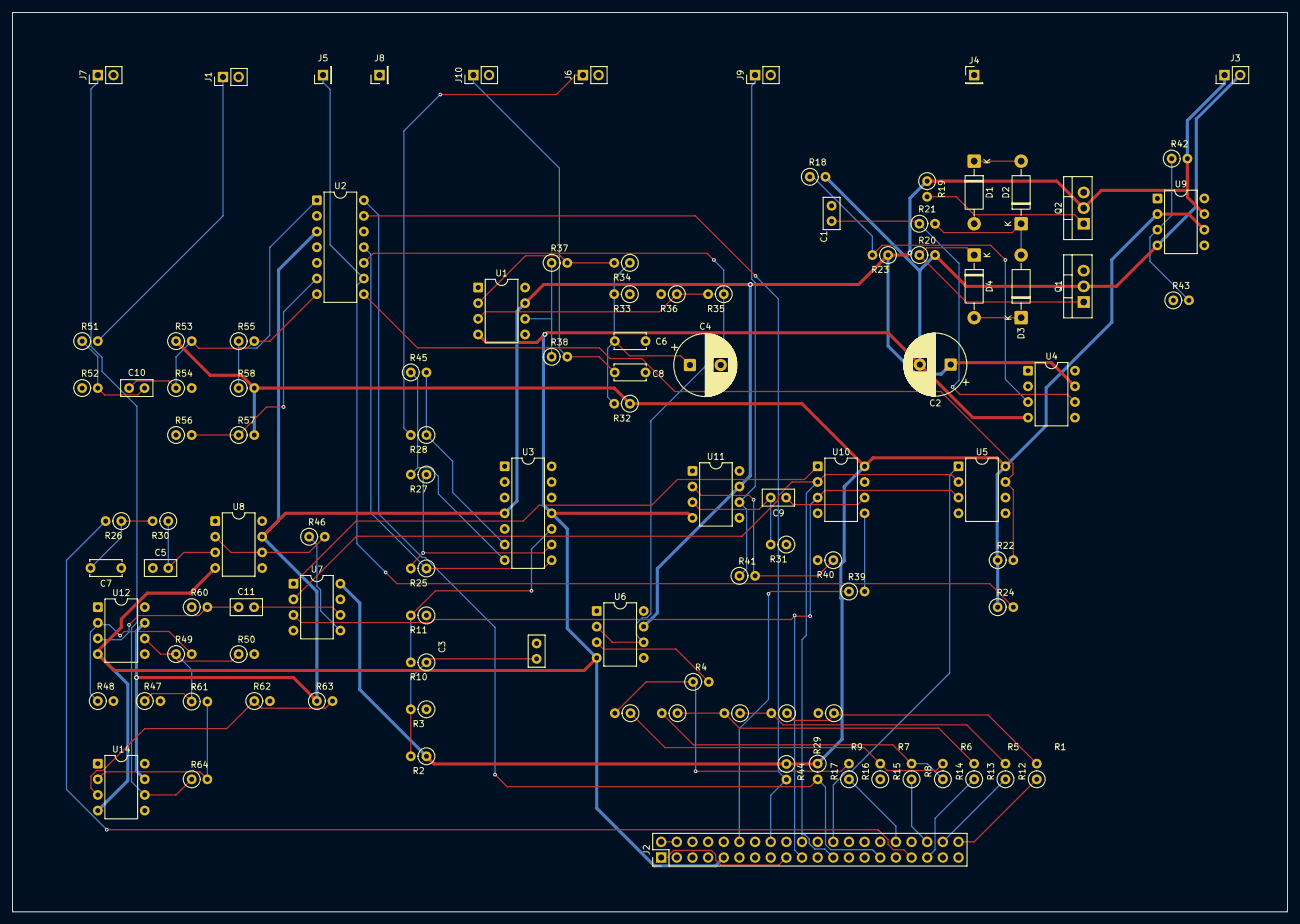
[picture p48: board Group4_CheckpointA_KiCad_4-20-26.kicad_pcb from above]

Board: 2 copper layers, 206.9 x 146.0 mm, 103 parts (0 on the bottom side), 70 nets.
