dustpot/electronic-test-bench/(commit log)

2026-10-09 Add Electronic Test Bench project: software, KiCad hardware, schematics, docs
    Claude-Session: https://claude.ai/code/session_01HwzitKrHXozu1HZcKfrnpK
    [DC Reference.kicad_sch, Function Generator.kicad_sch, Group4_CheckpointA_KiCad_4-20-26.kicad_pcb, Group4_CheckpointA_KiCad_4-20-26.kicad_sch, Voltage Reference Buffer.kicad_sch, digipotCPKTB.kicad_sch, freq_measure.kicad_sch, ohmmeter.kicad_sch]
2026-10-09 Replace schematics with exported KiCad schematic PDFs (1-5)
    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
2026-10-09 Add schematic PDFs 6-9
    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
